nerdy-nikkie/sesame-robot/software/README.md

# Software

Software applications for making the most of your Sesame Robot.

## Tools

### [Sesame Studio](https://github.com/dorianborian/sesame-studio)
A PySide6-based animation, pose sequencing, and OLED face design tool.

- **3D Posable Viewport**: Real printed-part geometry, live-driven by servo angles, with joint calibration.
- **Timeline Editor**: Sequence, reorder, retime, and preview poses in real time.
- **Face Editor & Firmware Editor**: Paint 128x64 OLED expressions, or directly open, edit, and save Arduino `face-bitmaps.h` files with live hex preview.
- **Projects & Export**: Save/load `.sesproj` files, export firmware-ready code with an in-app integration guide.

**Note:** Sesame Studio is maintained in its own dedicated repository at [https://github.com/dorianborian/sesame-studio](https://github.com/dorianborian/sesame-studio).

[Go to Sesame Studio Repository ->](https://github.com/dorianborian/sesame-studio)

### Sesame Companion App
A Python application for advanced robot control and interaction over your local network.

- **Voice Control**: Integrate with speech recognition for voice commands.
- **Emotion Mapping**: Automatically set robot expressions based on sentiment analysis.
- **Remote API Control**: Send commands and face changes via the JSON API.
- **Network Mode**: Requires robot firmware with network mode enabled.
- **Home Automation**: Example integrations with Home Assistant and other platforms.

**Note:** The Companion App is a separate repository and requires the latest firmware with network mode enabled.

[Go to Sesame Companion App Repository ->](https://github.com/dorianborian/sesame-companion-app)
