nerdy-nikkie/sesame-robot/docs/images/sesamefaces/tachikoma.png

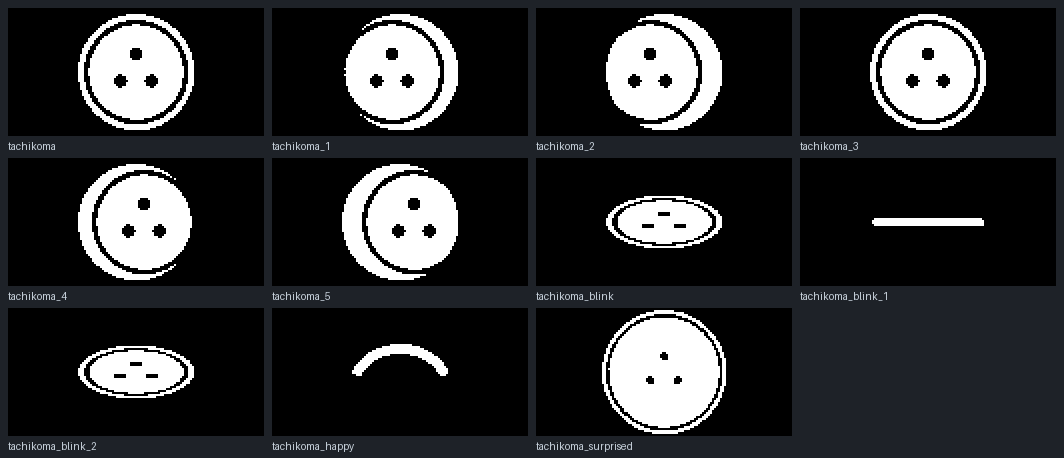
docs/images/sesamefaces/tachikoma.png
