nerdy-nikkie/sesame-robot/docs/images/tachikoma/tachikoma-back.png

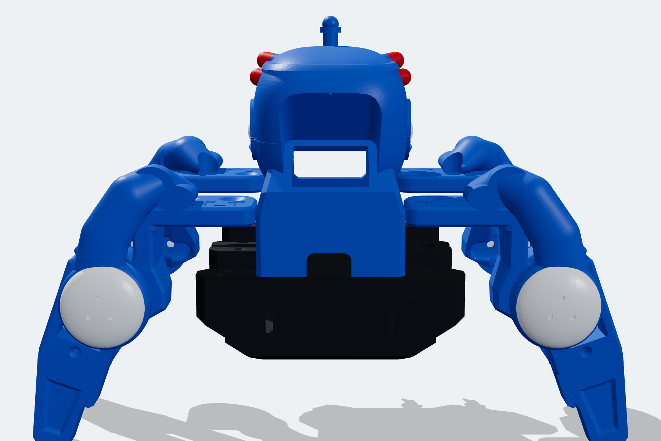
docs/images/tachikoma/tachikoma-back.png
