nerdy-nikkie/sesame-robot/docs/images/tachikoma/tachikoma-front.png

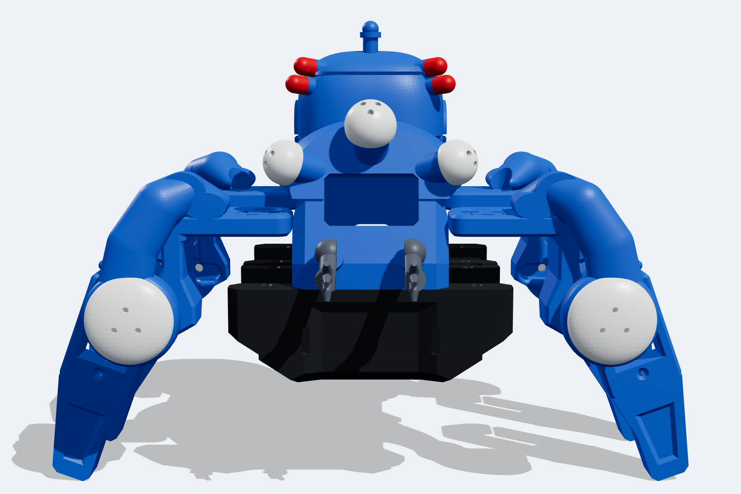
docs/images/tachikoma/tachikoma-front.png
