nerdy-nikkie/sesame-robot/docs/images/tachikoma/tachikoma-side.png

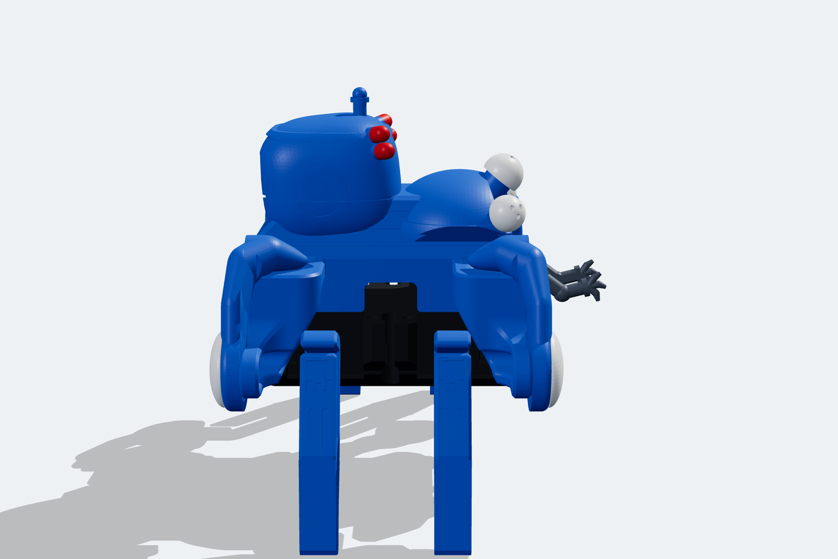
docs/images/tachikoma/tachikoma-side.png
