nerdy-nikkie/sesame-robot/hardware/printing/stl/tachikoma/Top-Cover-Tachikoma-v200.stl

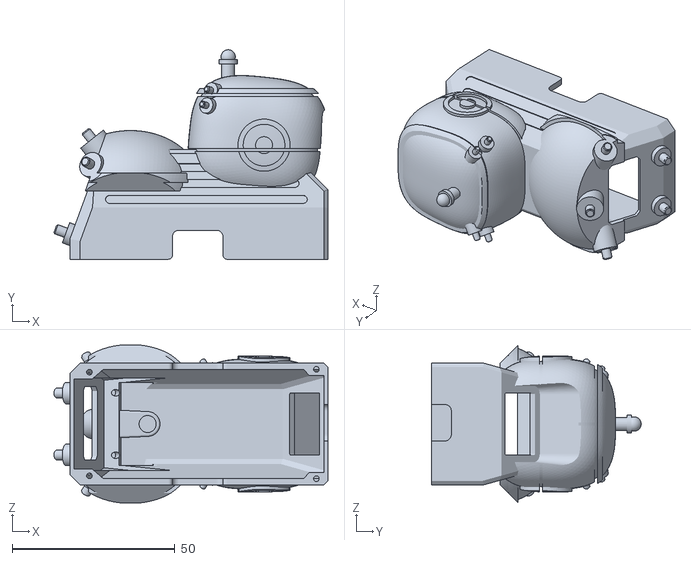
[picture p5: CAD file, 2026-10-29]
hardware/printing/stl/tachikoma/Top-Cover-Tachikoma-v200.stl
84.1 x 64.3 x 48.4
