nerdy-nikkie/sesame-robot/hardware/printing/stl/tachikoma/L2-Tachikoma-v100.stl

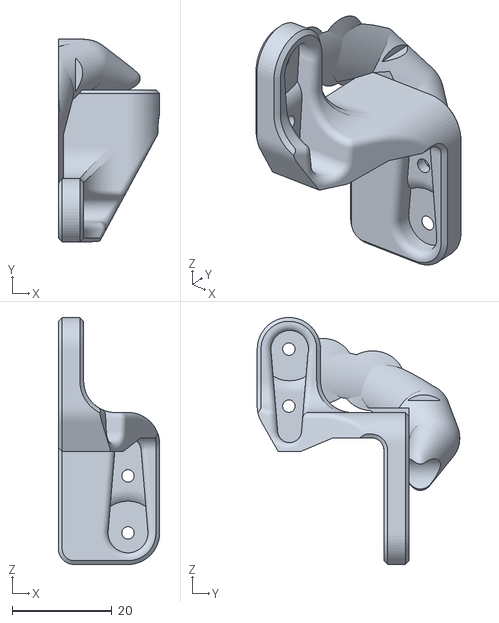
[picture p6: CAD file, 2026-10-29]
hardware/printing/stl/tachikoma/L2-Tachikoma-v100.stl
20.3 x 40.6 x 49.5
