nerdy-nikkie/sesame-robot/hardware/printing/stl/tachikoma/Eyes-Tachikoma-v200-print-3-white.stl

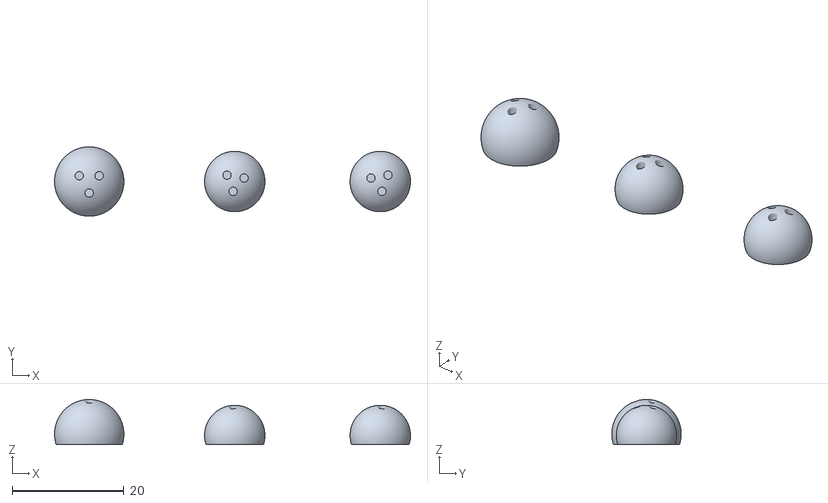
[picture p7: CAD file, 2026-10-29]
hardware/printing/stl/tachikoma/Eyes-Tachikoma-v200-print-3-white.stl
63.6 x 12.4 x 8.06
