nerdy-nikkie/sesame-robot/hardware/printing/stl/tachikoma/R3-Tachikoma-v100.stl

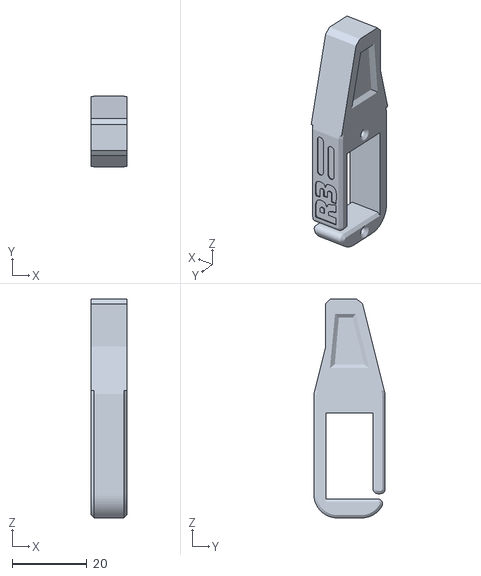
[picture p8: CAD file, 2026-10-29]
hardware/printing/stl/tachikoma/R3-Tachikoma-v100.stl
9.53 x 19.0 x 58.4
