nerdy-nikkie/sesame-robot/hardware/printing/stl/tachikoma/Lights-Tachikoma-v200-print-4-red.stl

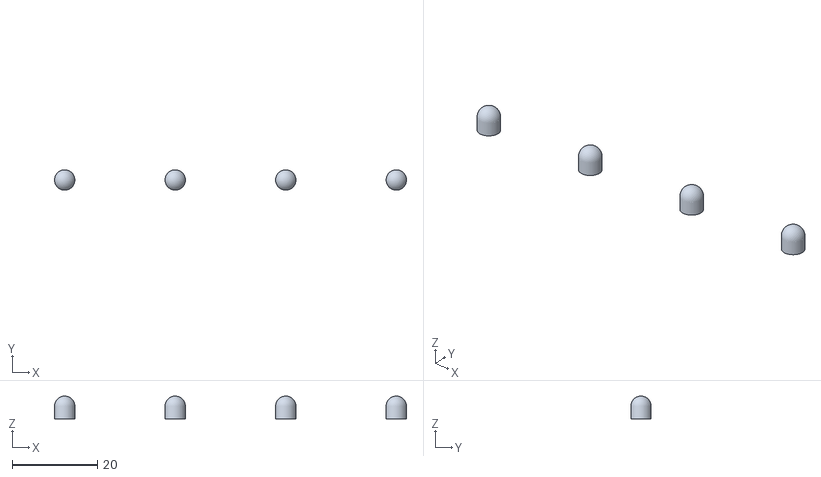
[picture p9: CAD file, 2026-10-29]
hardware/printing/stl/tachikoma/Lights-Tachikoma-v200-print-4-red.stl
82.8 x 4.80 x 5.40
