nerdy-nikkie/sesame-robot/hardware/printing/stl/tachikoma/Knee-Cap-Tachikoma-v100.stl

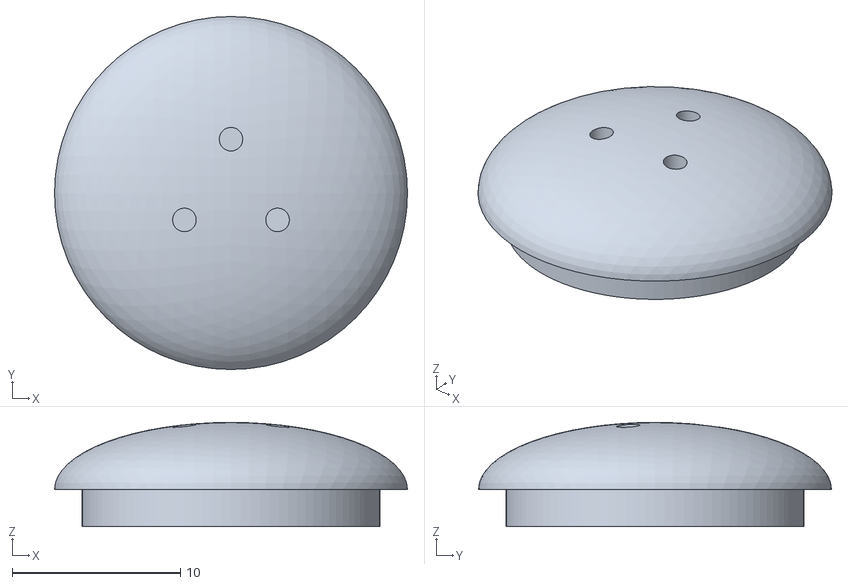
[picture p10: CAD file, 2026-10-29]
hardware/printing/stl/tachikoma/Knee-Cap-Tachikoma-v100.stl
21.0 x 21.0 x 6.20
