nerdy-nikkie/sesame-robot/hardware/printing/stl/tachikoma/Thigh-Shell-Tachikoma-v100-B.stl

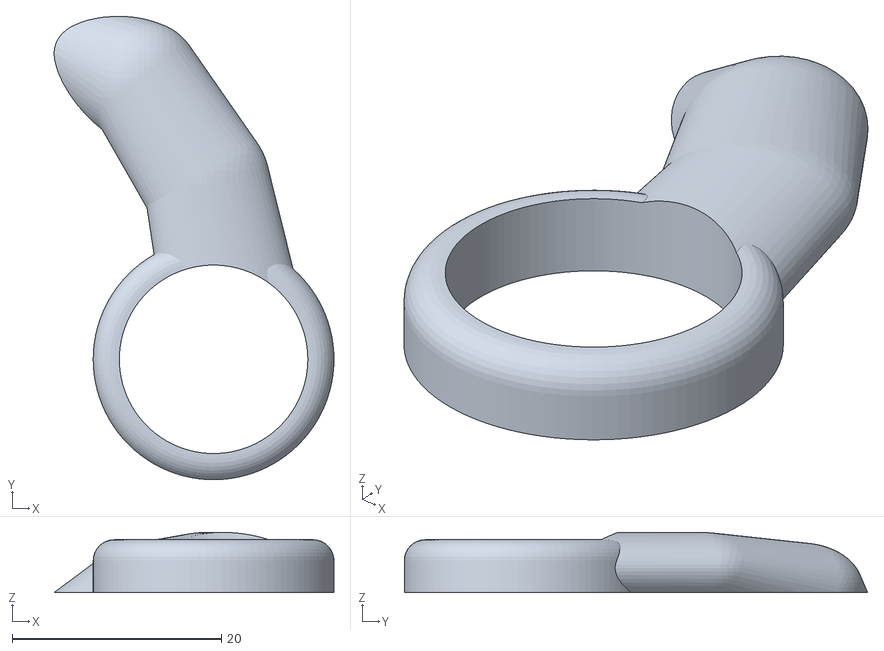
[picture p11: CAD file, 2026-10-29]
hardware/printing/stl/tachikoma/Thigh-Shell-Tachikoma-v100-B.stl
26.7 x 44.3 x 5.75
