nerdy-nikkie/sesame-robot/hardware/printing/stl/tachikoma/Arms-Tachikoma-v200-print-2.stl

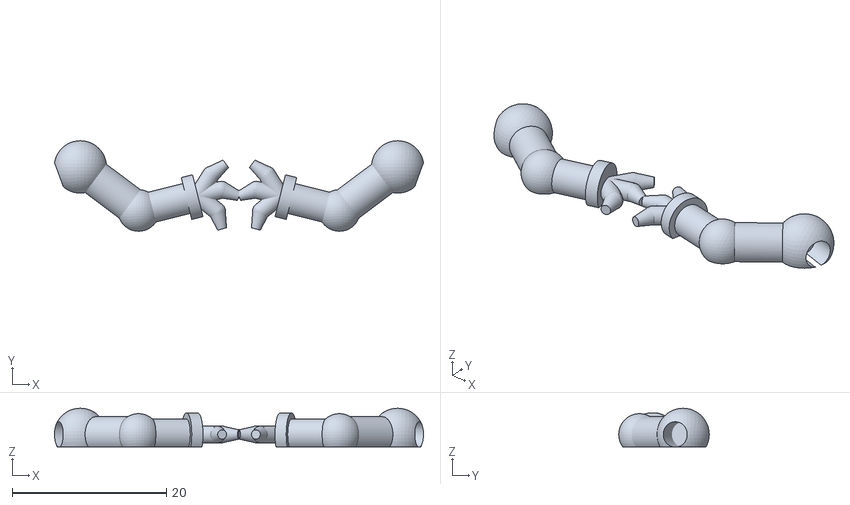
[picture p12: CAD file, 2026-10-29]
hardware/printing/stl/tachikoma/Arms-Tachikoma-v200-print-2.stl
47.8 x 11.7 x 5.00
