nerdy-nikkie/sesame-robot/(list of files, cad)

Other CAD files:
hardware/printing/stl/tachikoma/L1-Tachikoma-v100.stl
hardware/printing/stl/tachikoma/L3-Tachikoma-v100.stl
hardware/printing/stl/tachikoma/R1-Tachikoma-v100.stl
hardware/printing/stl/tachikoma/R2-Tachikoma-v100.stl
hardware/printing/stl/tachikoma/L4-Tachikoma-v100.stl
hardware/printing/stl/tachikoma/R4-Tachikoma-v100.stl
hardware/printing/stl/tachikoma/Thigh-Shell-Tachikoma-v100-A.stl
