nerdy-nikkie/sesame-robot/hardware/printing/stl/top-covers/README.md

# Top Cover Styles

## Enclosed v100
Current modern version of sesame top cover, includes 5mm x 2mm magnet slots for hats! Front display wires are covered, supports multicolor details.

## Cat v100
Modern Version of the enclosed top cover with cat ears instead of stubby ears! Updated with all current features with magnet support for hats, and multicolor details.

## No Ears v100
Template for designing your own ears for Sesame. The areas right next to where the ears ussually go is a little thin so this version is only really meant for desiging ears onto. (Includes all previously mentioned features)

## Tachikoma
See the [Tachikoma Kit](../tachikoma/) for the Tachikoma cover, legs and details.
