nerdy-nikkie/sesame-robot/(notices)

Notices in the files:
README.md:
License: APACHE2.0
